madmarkarnel/lora-transmission/pcb board/atsamdg21/atsamdg21_v1.20.brd

## EAGLE design pcb board/atsamdg21/atsamdg21_v1.20.brd (2020-06-10)

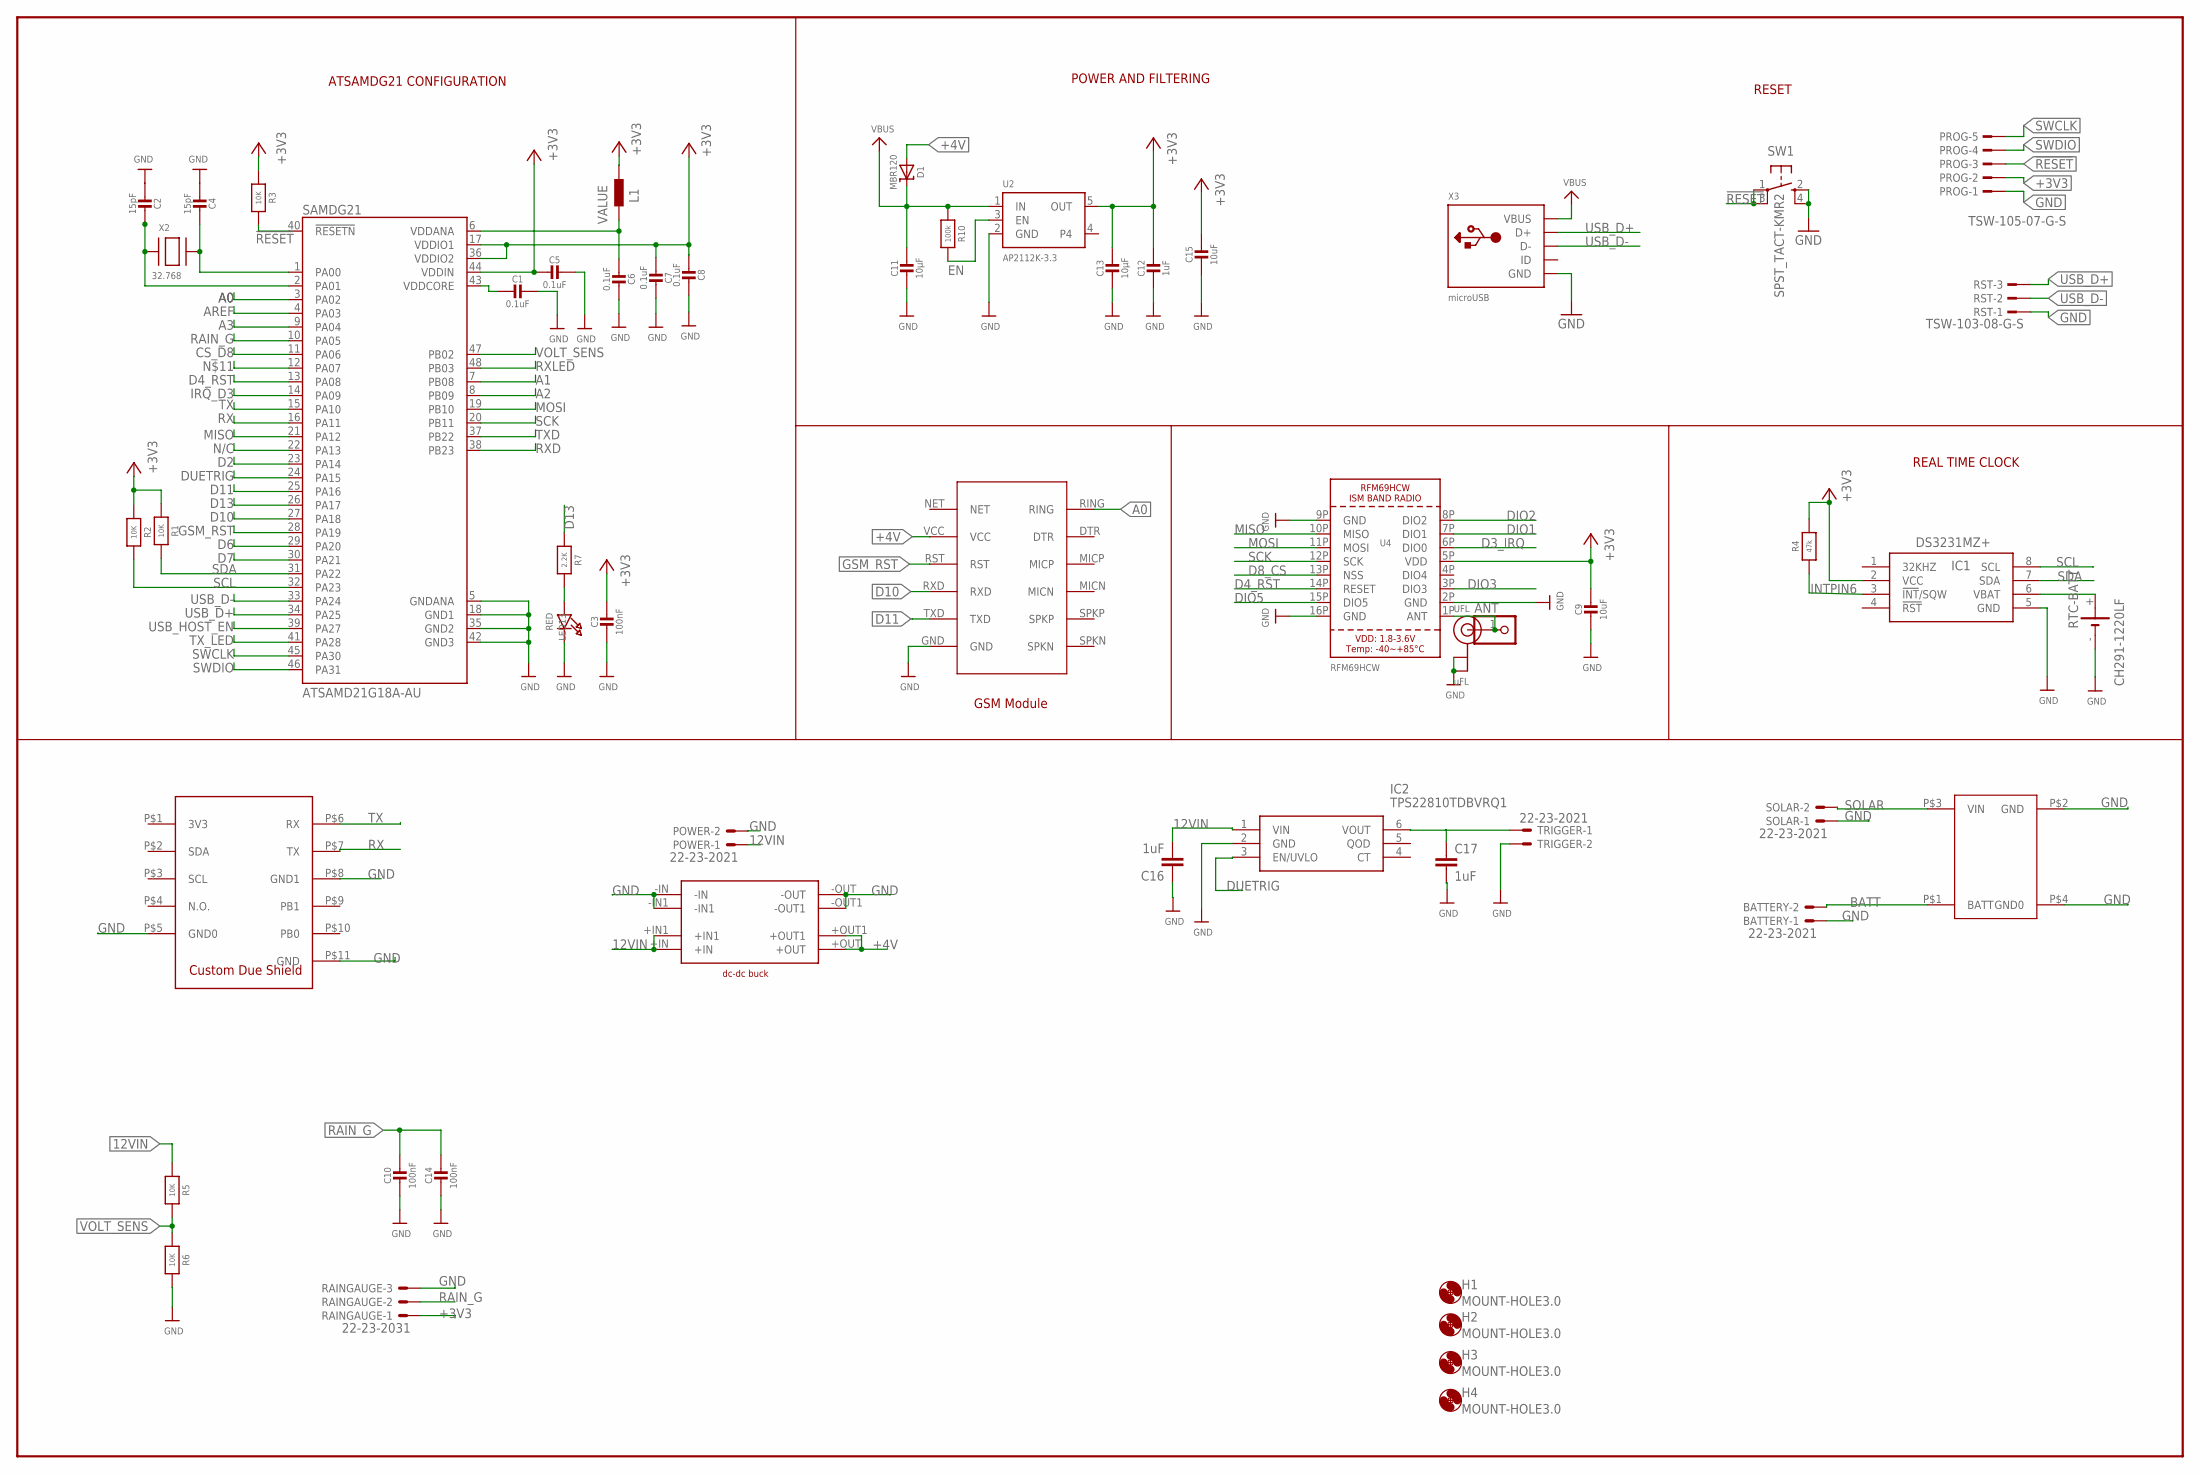
[picture p1: schematic atsamdg21_v1.20.sch]

Parts:
ANT: HEADER-1X1ROUND; 1X01_ROUND
BATTERY: 22-23-2021
C1, C5, C6, C7, C8: 0.1uF; 0603-NO
C2, C4: 15pF; 0603-NO
C3, C10, C14: 100nF; 0603-NO
C9, C15: 10uF; 0805-NO
C11, C13: 10µF; 0805-NO
C12: 1uF; 0603-NO
C16, C17: 1uF; C0603
D1: MBR120; SOD-123
H1, H2, H3, H4: MOUNT-HOLE3.0; 3,0
IC1: DS3231MZ+; SOIC127P600X175-8N
IC2: TPS22810TDBVRQ1; SOT95P280X145-6N
L1: BLM15HB121SN1; 0402
LED13: RED; CHIPLED_0805_NOOUTLINE
POWER: 22-23-2021
PROG: TSW-105-07-G-S; TSW-105-XX-G-S
R1, R2, R3, R5, R6: 10K; 0603-NO
R4: 47k; 0603-NO
R7: 2.2K; 0603-NO
R10: 100k; 0603-NO
RAINGAUGE: 22-23-2031
RST: TSW-103-08-G-S; TSW-103-XX-G-S
RTC-BATT: CH291-1220LF
SAMDG21: ATSAMD21G18A-AU; QFP50P900X900X120-48N
SOLAR: 22-23-2021
SW1: SPST_TACT-KMR2; KMR2
TRIGGER: 22-23-2021
U2: AP2112K-3.3; SOT23-5
U4: RFM69HCW; RFMHCW_SMT
U$7: SIM800L_MODULE; SIM800L
U$19: DC-DC_BUCK_MAD; DC-DC_BUCK
U$20: DUE_PADSDUE_GSM; DUESHIELD_BIG
U$36: LI-ION-CHARGER; LI-ION
UFL: uFL; U.FL
X2: 32.768; XTAL3215
X3: microUSB; 4UCONN_20329_V2

Connections:
12VIN: C16.2, IC2.1 (VIN), POWER.1, R5.1, U$19.+IN, U$19.+IN1
!RESET: PROG.3, R3.2, SAMDG21.40 (!RESETN), SW1.1, SW1.3 (P1)
+3V3: C3.1, C5.2, C7.2, C8.2, C9.1, C12.1, C13.1, C15.1, IC1.2 (VCC), L1.1, PROG.2, R1.1, R2.1, R3.1, R4.2, RAINGAUGE.1, SAMDG21.17 (VDDIO1), SAMDG21.36 (VDDIO2), SAMDG21.44 (VDDIN), U2.5 (OUT), U4.5P (VDD)
+4V: D1.A, U$7.VCC, U$19.+OUT, U$19.+OUT1
A0: SAMDG21.3 (PA02), U$7.RING
A1: SAMDG21.7 (PB08)
A2: SAMDG21.8 (PB09)
A3: SAMDG21.9 (PA04)
ANT: ANT.1, U4.1P (ANT), UFL.3 (SIGNAL)
AREF: SAMDG21.4 (PA03)
BATT: BATTERY.2, U$36.P$1 (BATT)
CS_D8: SAMDG21.11 (PA06)
D2: SAMDG21.23 (PA14)
D3_IRQ: U4.6P (DIO0)
D4_RST: SAMDG21.13 (PA08), U4.14P (RESET)
D6: SAMDG21.29 (PA20)
D7: SAMDG21.30 (PA21)
D8_CS: U4.13P (NSS)
D10: SAMDG21.27 (PA18), U$7.RXD
D11: SAMDG21.25 (PA16), U$7.TXD
D13: R7.1, SAMDG21.26 (PA17)
DIO1: U4.7P (DIO1)
DIO2: U4.8P (DIO2)
DIO3: U4.3P (DIO3)
DIO5: U4.15P (DIO5)
DUETRIG: IC2.3 (EN/UVLO), SAMDG21.24 (PA15)
EN: R10.2, U2.3 (EN)
GND: BATTERY.1, C1.1, C2.2, C3.2, C4.2, C5.1, C6.1, C7.1, C8.1, C9.2, C10.2, C11.2, C12.2, C13.2, C14.2, C15.2, C16.1, C17.2, IC1.5 (GND), IC2.2 (GND), LED13.C, POWER.2, PROG.1, R6.2, RAINGAUGE.3, RST.1, RTC-BATT.-, SAMDG21.5 (GNDANA), SAMDG21.18 (GND1), SAMDG21.35 (GND2), SAMDG21.42 (GND3), SOLAR.1, SW1.2 (S), SW1.4 (S1), TRIGGER.2, U2.2 (GND), U4.2P (GND), U4.9P (GND), U4.16P (GND), U$7.GND, U$19.-IN, U$19.-IN1, U$19.-OUT, U$19.-OUT1, U$20.P$5 (GND0), U$20.P$8 (GND1), U$20.P$11 (GND), U$36.P$2 (GND), U$36.P$4 (GND0), UFL.1 (GND), UFL.2 (GND), X3.BASE@1 (GND), X3.BASE@2 (GND), X3.GND, X3.SPRT@1 (GND), X3.SPRT@2 (GND), X3.SPRT@3 (GND), X3.SPRT@4 (GND)
GSM_RST: SAMDG21.28 (PA19), U$7.RST
INTPIN6: IC1.3 (!INT!/SQW), R4.1
IRQ_D3: SAMDG21.14 (PA09)
MISO: SAMDG21.21 (PA12), U4.10P (MISO)
MOSI: SAMDG21.19 (PB10), U4.11P (MOSI)
unnamed: C1.2, SAMDG21.43 (VDDCORE)
unnamed: IC1.6 (VBAT), RTC-BATT.+
unnamed: C6.2, L1.2, SAMDG21.6 (VDDANA)
unnamed: C2.1, SAMDG21.2 (PA01), X2.P$1
unnamed: C17.1, IC2.6 (VOUT), TRIGGER.1
unnamed: C4.1, SAMDG21.1 (PA00), X2.P$2
unnamed: LED13.A, R7.2
N/C: SAMDG21.22 (PA13)
RAIN_G: C10.1, C14.1, RAINGAUGE.2, SAMDG21.10 (PA05)
RX: SAMDG21.16 (PA11), U$20.P$7 (TX)
RXD: SAMDG21.38 (PB23)
RXLED: SAMDG21.48 (PB03)
SCK: SAMDG21.20 (PB11), U4.12P (SCK)
SCL: IC1.8 (SCL), R2.2, SAMDG21.32 (PA23)
SDA: IC1.7 (SDA), R1.2, SAMDG21.31 (PA22)
SOLAR: SOLAR.2, U$36.P$3 (VIN)
SWCLK: PROG.5, SAMDG21.45 (PA30)
SWDIO: PROG.4, SAMDG21.46 (PA31)
TX: SAMDG21.15 (PA10), U$20.P$6 (RX)
TXD: SAMDG21.37 (PB22)
TX_LED: SAMDG21.41 (PA28)
USB_D+: RST.3, SAMDG21.34 (PA25), X3.D+
USB_D-: RST.2, SAMDG21.33 (PA24), X3.D-
USB_HOST_EN: SAMDG21.39 (PA27)
VBUS: C11.1, D1.C, R10.1, U2.1 (IN), X3.VBUS
VOLT_SENS: R5.2, R6.1, SAMDG21.47 (PB02)

Notes on the sheet:
GSM Module
POWER AND FILTERING
RESET
ATSAMDG21 CONFIGURATION
REAL TIME CLOCK

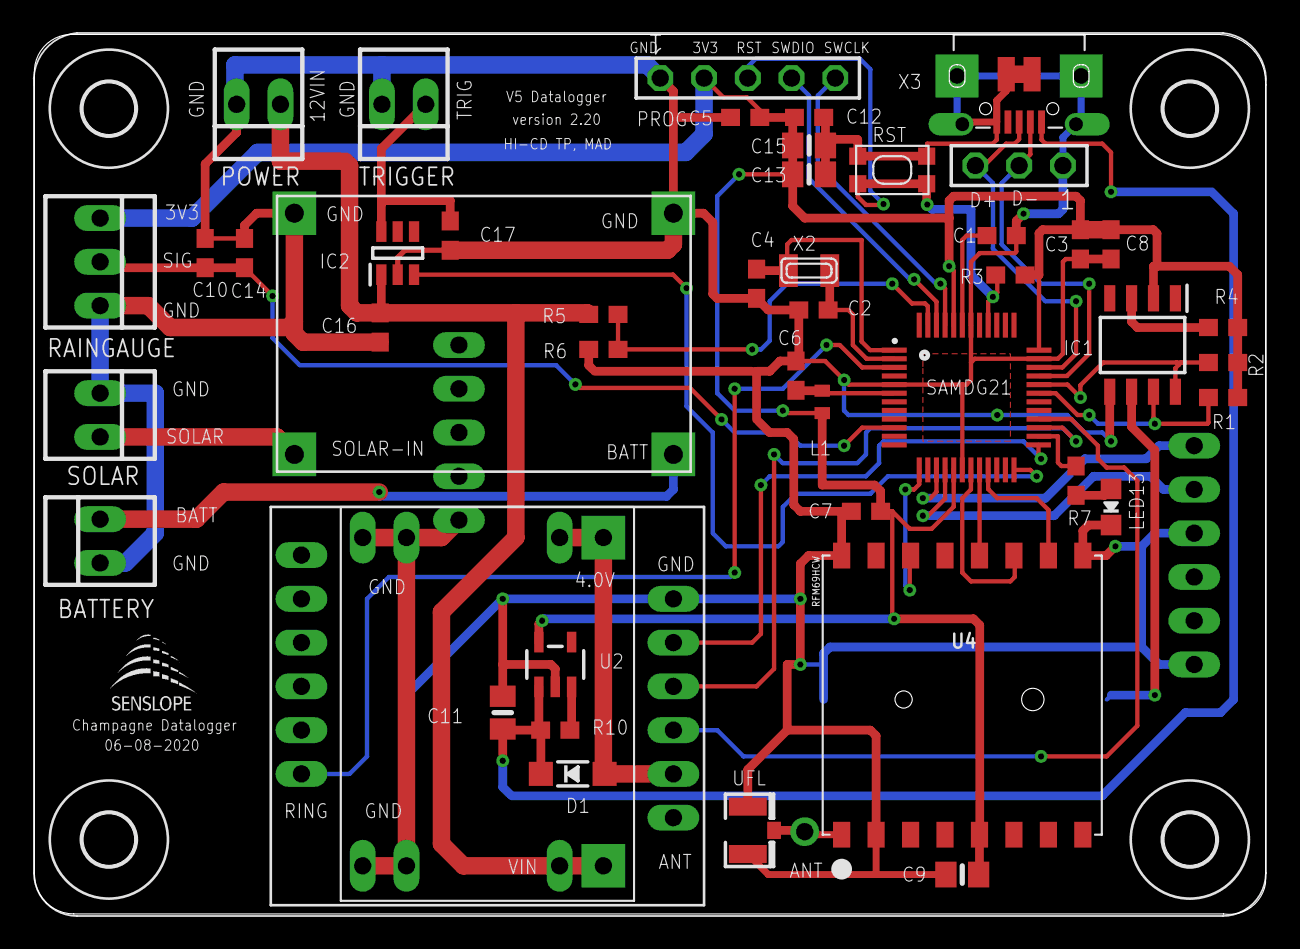
[picture p2: board atsamdg21_v1.20.brd from above]

Board: 2 copper layers, 71.5 x 51.1 mm, 55 parts (1 on the bottom side), 38 nets.

Other parts of the board:
U$24: LOGO_SML_TNAME
