madmarkarnel/lora-transmission/pcb board/gsm_LoRa/gsm_LoRa_due.brd

## EAGLE design pcb board/gsm_LoRa/gsm_LoRa_due.brd (2020-06-09)

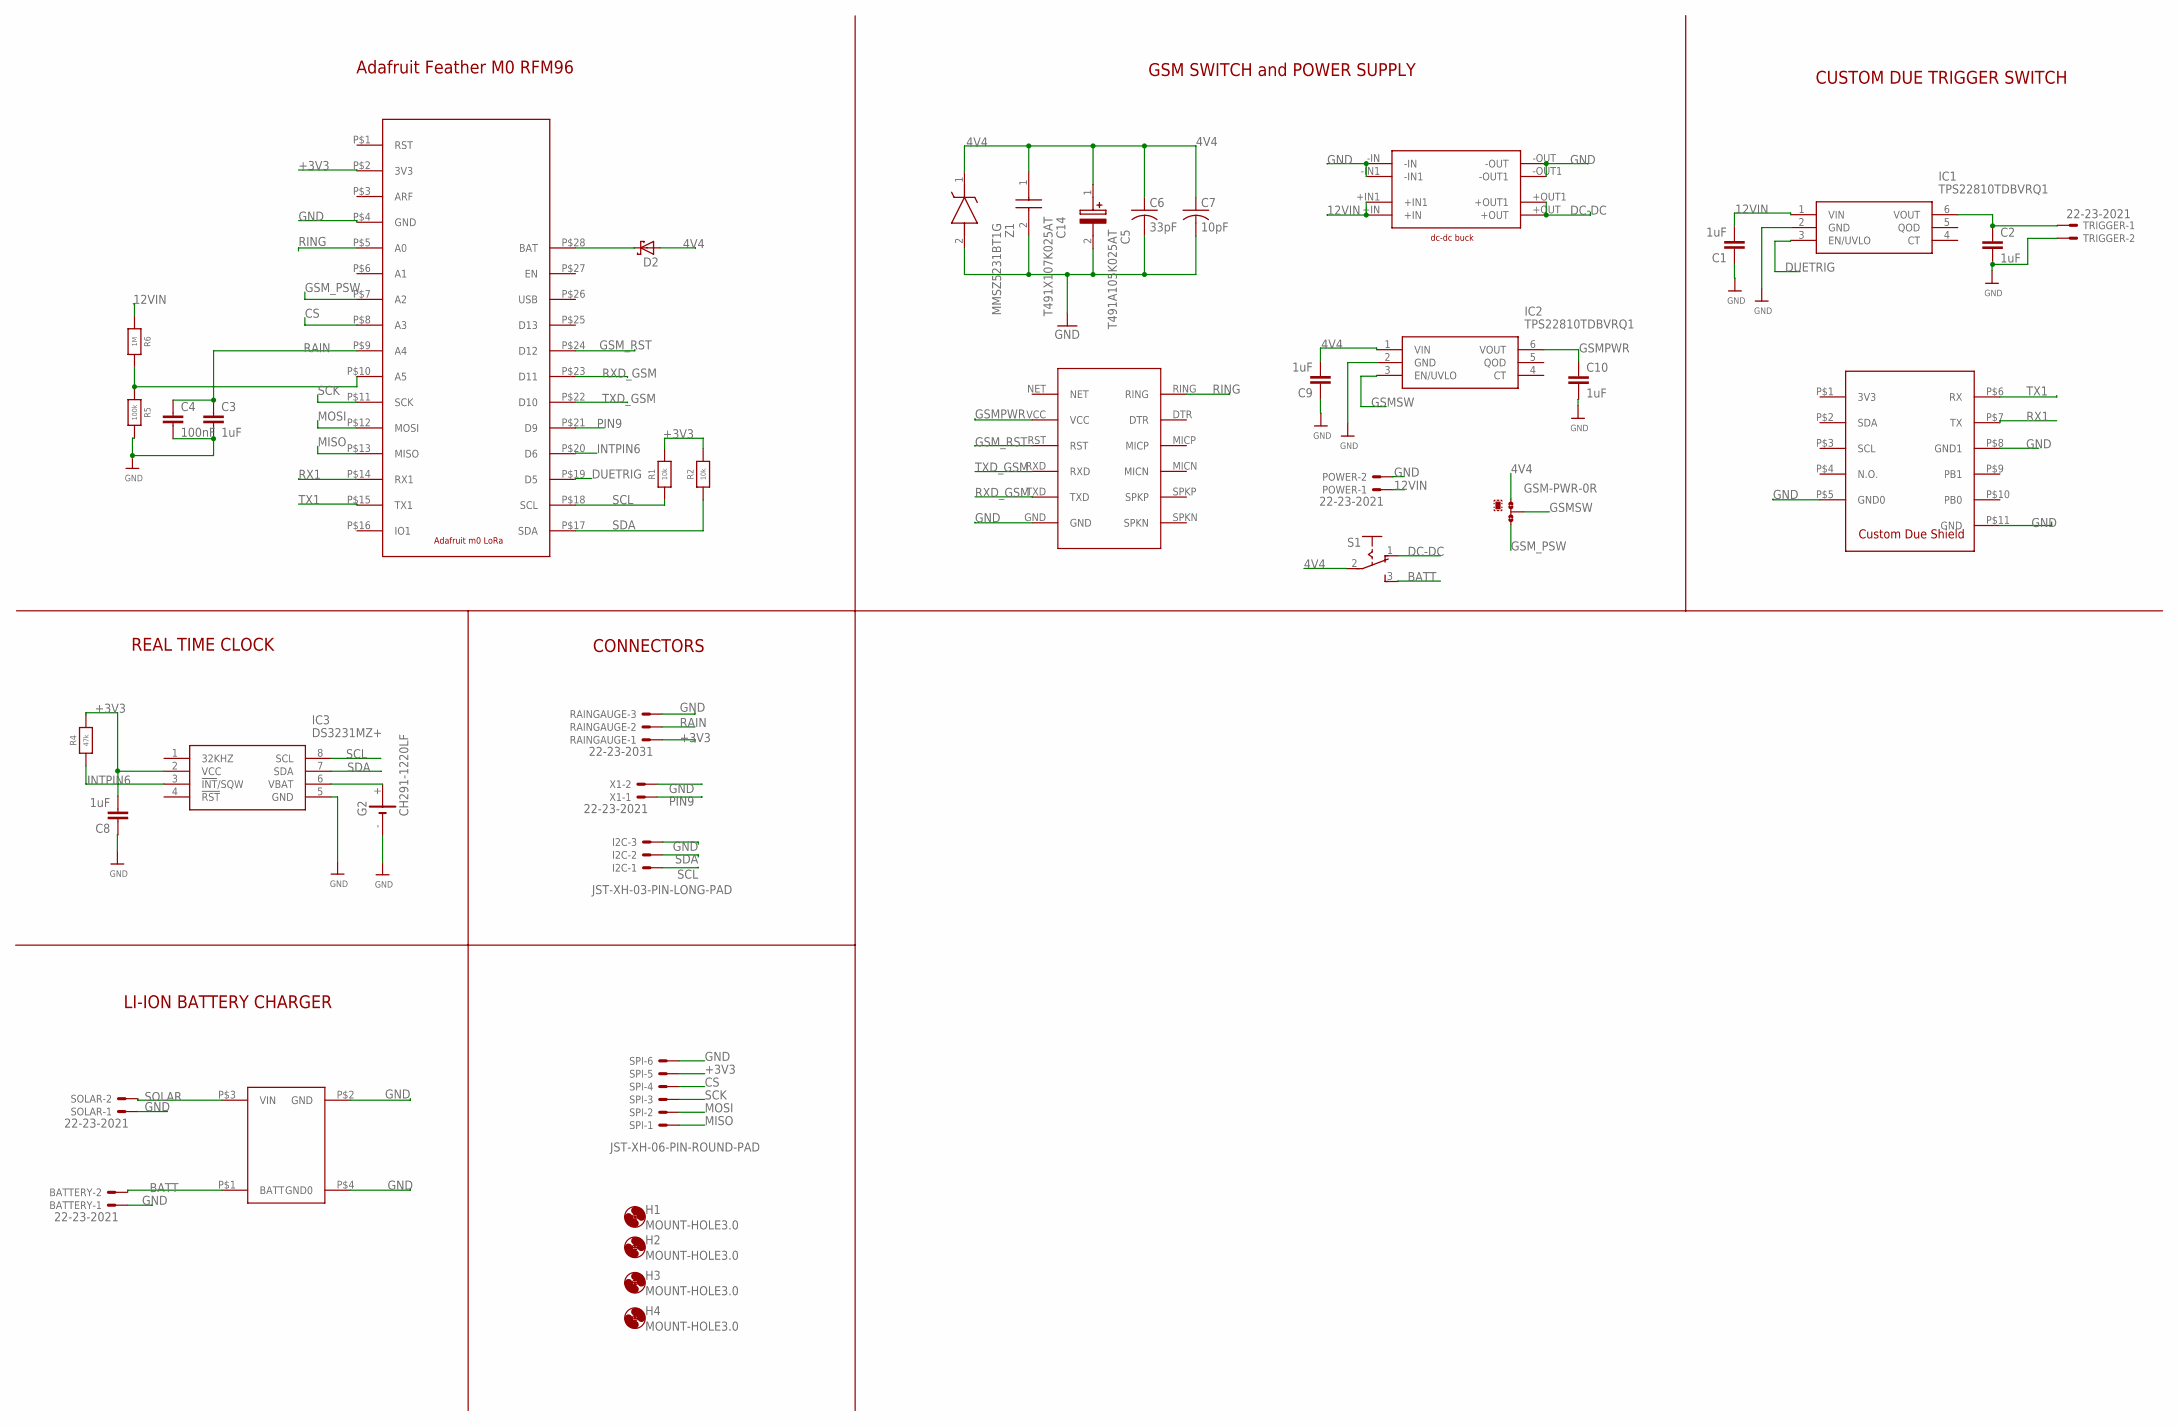
[picture p3: schematic gsm_LoRa_due.sch]

Parts:
BATTERY: 22-23-2021
C1, C2, C3, C8, C9, C10: 1uF; C0603
C4: 100nF; C0603
C5: T491A105K025AT; CAPPM3216X180N
C6: 33pF; C0603
C7: 10pF; C0603
C14: T491X107K025AT; CAPPM7343X430N
D2: SCHOTTKY-DIODE; DIODE_SMB
G2: CH291-1220LF
GSM-PWR: 0R-JUMPB; B0R-JMP
H1, H2, H3, H4: MOUNT-HOLE3.0; 3,0
I2C: JST-XH-03-PIN-LONG-PAD; JST-XH-03-PACKAGE-LONG-PAD
IC1, IC2: TPS22810TDBVRQ1; SOT95P280X145-6N
IC3: DS3231MZ+; SOIC127P600X175-8N
POWER: 22-23-2021
R1, R2: 10k; 0603-NO
R4: 47k; 0603-NO
R5: 100k; 0603-NO
R6: 1M; 0603-NO
RAINGAUGE: 22-23-2031
S1: 255SB
SOLAR: 22-23-2021
SPI: JST-XH-06-PIN-ROUND-PAD; JST-XH-06-PACKAGE-ROUND-PAD
TRIGGER: 22-23-2021
U$1: M0_LORA; RFM69
U$8: DUE_PADSDUE_GSM; DUESHIELD_BIG
U$9: SIM800L_MODULE; SIM800L
U$10: DC-DC_BUCK_MAD; DC-DC_BUCK
U$11: LI-ION-CHARGER; LI-ION
X1: 22-23-2021
Z1: MMSZ5231BT1G; SOD3716X135N

Connections:
4V4: C5.1 (+), C6.1, C7.1, C9.2, C14.1, D2.A (C), GSM-PWR.1, IC2.1 (VIN), S1.2, Z1.1 (K)
12VIN: C1.2, IC1.1 (VIN), POWER.1, R6.1, U$10.+IN, U$10.+IN1
+3V3: C8.2, IC3.2 (VCC), R1.2, R2.2, R4.2, RAINGAUGE.1, SPI.5, U$1.P$2 (3V3)
BATT: BATTERY.2, S1.3 (S), U$11.P$1 (BATT)
CS: SPI.4, U$1.P$8 (A3)
DC-DC: S1.1 (O), U$10.+OUT, U$10.+OUT1
DUETRIG: IC1.3 (EN/UVLO), U$1.P$19 (D5)
GND: BATTERY.1, C1.1, C2.2, C3.2, C4.2, C5.2 (-), C6.2, C7.2, C8.1, C9.1, C10.2, C14.2, G2.-, I2C.3, IC1.2 (GND), IC2.2 (GND), IC3.5 (GND), POWER.2, R5.2, RAINGAUGE.3, SOLAR.1, SPI.6, TRIGGER.2, U$1.P$4 (GND), U$8.P$5 (GND0), U$8.P$8 (GND1), U$8.P$11 (GND), U$9.GND, U$10.-IN, U$10.-IN1, U$10.-OUT, U$10.-OUT1, U$11.P$2 (GND), U$11.P$4 (GND0), X1.2, Z1.2 (A)
GSMPWR: C10.1, IC2.6 (VOUT), U$9.VCC
GSMSW: GSM-PWR.2, IC2.3 (EN/UVLO)
GSM_PSW: GSM-PWR.3, U$1.P$7 (A2)
GSM_RST: U$1.P$24 (D12), U$9.RST
INTPIN6: IC3.3 (!INT!/SQW), R4.1, U$1.P$20 (D6)
MISO: SPI.1, U$1.P$13 (MISO)
MOSI: SPI.2, U$1.P$12 (MOSI)
unnamed: D2.C (A), U$1.P$28 (BAT)
unnamed: G2.+, IC3.6 (VBAT)
unnamed: R5.1, R6.2, U$1.P$10 (A5)
unnamed: C2.1, IC1.6 (VOUT), TRIGGER.1
PIN9: U$1.P$21 (D9), X1.1
RAIN: C3.1, C4.1, RAINGAUGE.2, U$1.P$9 (A4)
RING: U$1.P$5 (A0), U$9.RING
RX1: U$1.P$14 (RX1), U$8.P$7 (TX)
RXD_GSM: U$1.P$23 (D11), U$9.TXD
SCK: SPI.3, U$1.P$11 (SCK)
SCL: I2C.1, IC3.8 (SCL), R1.1, U$1.P$18 (SCL)
SDA: I2C.2, IC3.7 (SDA), R2.1, U$1.P$17 (SDA)
SOLAR: SOLAR.2, U$11.P$3 (VIN)
TX1: U$1.P$15 (TX1), U$8.P$6 (RX)
TXD_GSM: U$1.P$22 (D10), U$9.RXD

Notes on the sheet:
Adafruit Feather M0 RFM96
GSM SWITCH and POWER SUPPLY
CUSTOM DUE TRIGGER SWITCH
REAL TIME CLOCK
CONNECTORS
LI-ION BATTERY CHARGER

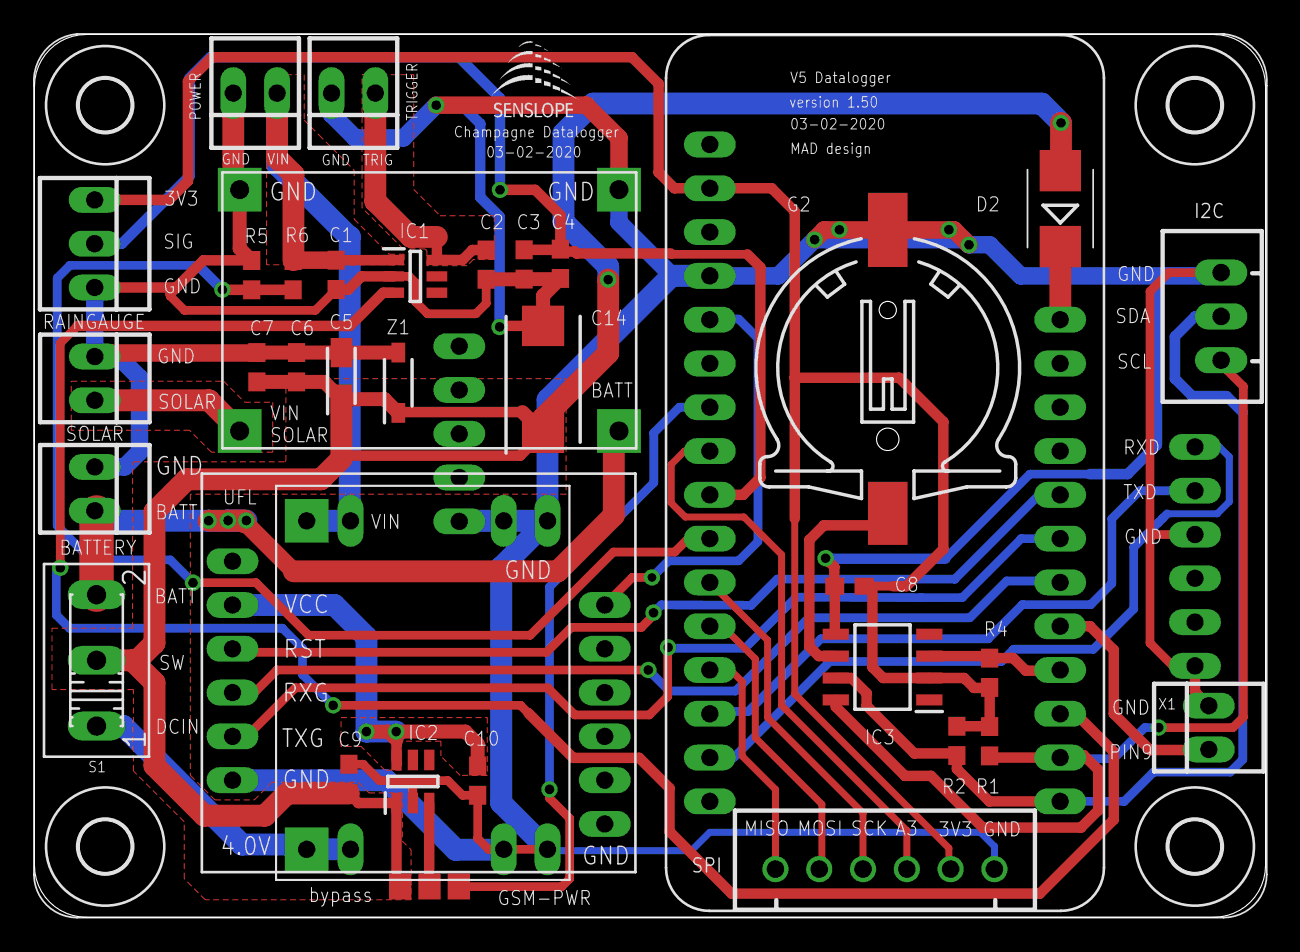
[picture p4: board gsm_LoRa_due.brd from above]

Board: 2 copper layers, 71.4 x 51.2 mm, 42 parts (0 on the bottom side), 30 nets.

Other parts of the board:
U$13: LOGO_SML_TNAME
