madmarkarnel/lora-transmission/pcb board/m0_BareBones/atsamdg21_rtc.brd

## EAGLE design pcb board/m0_BareBones/atsamdg21_rtc.brd (2020-02-28)

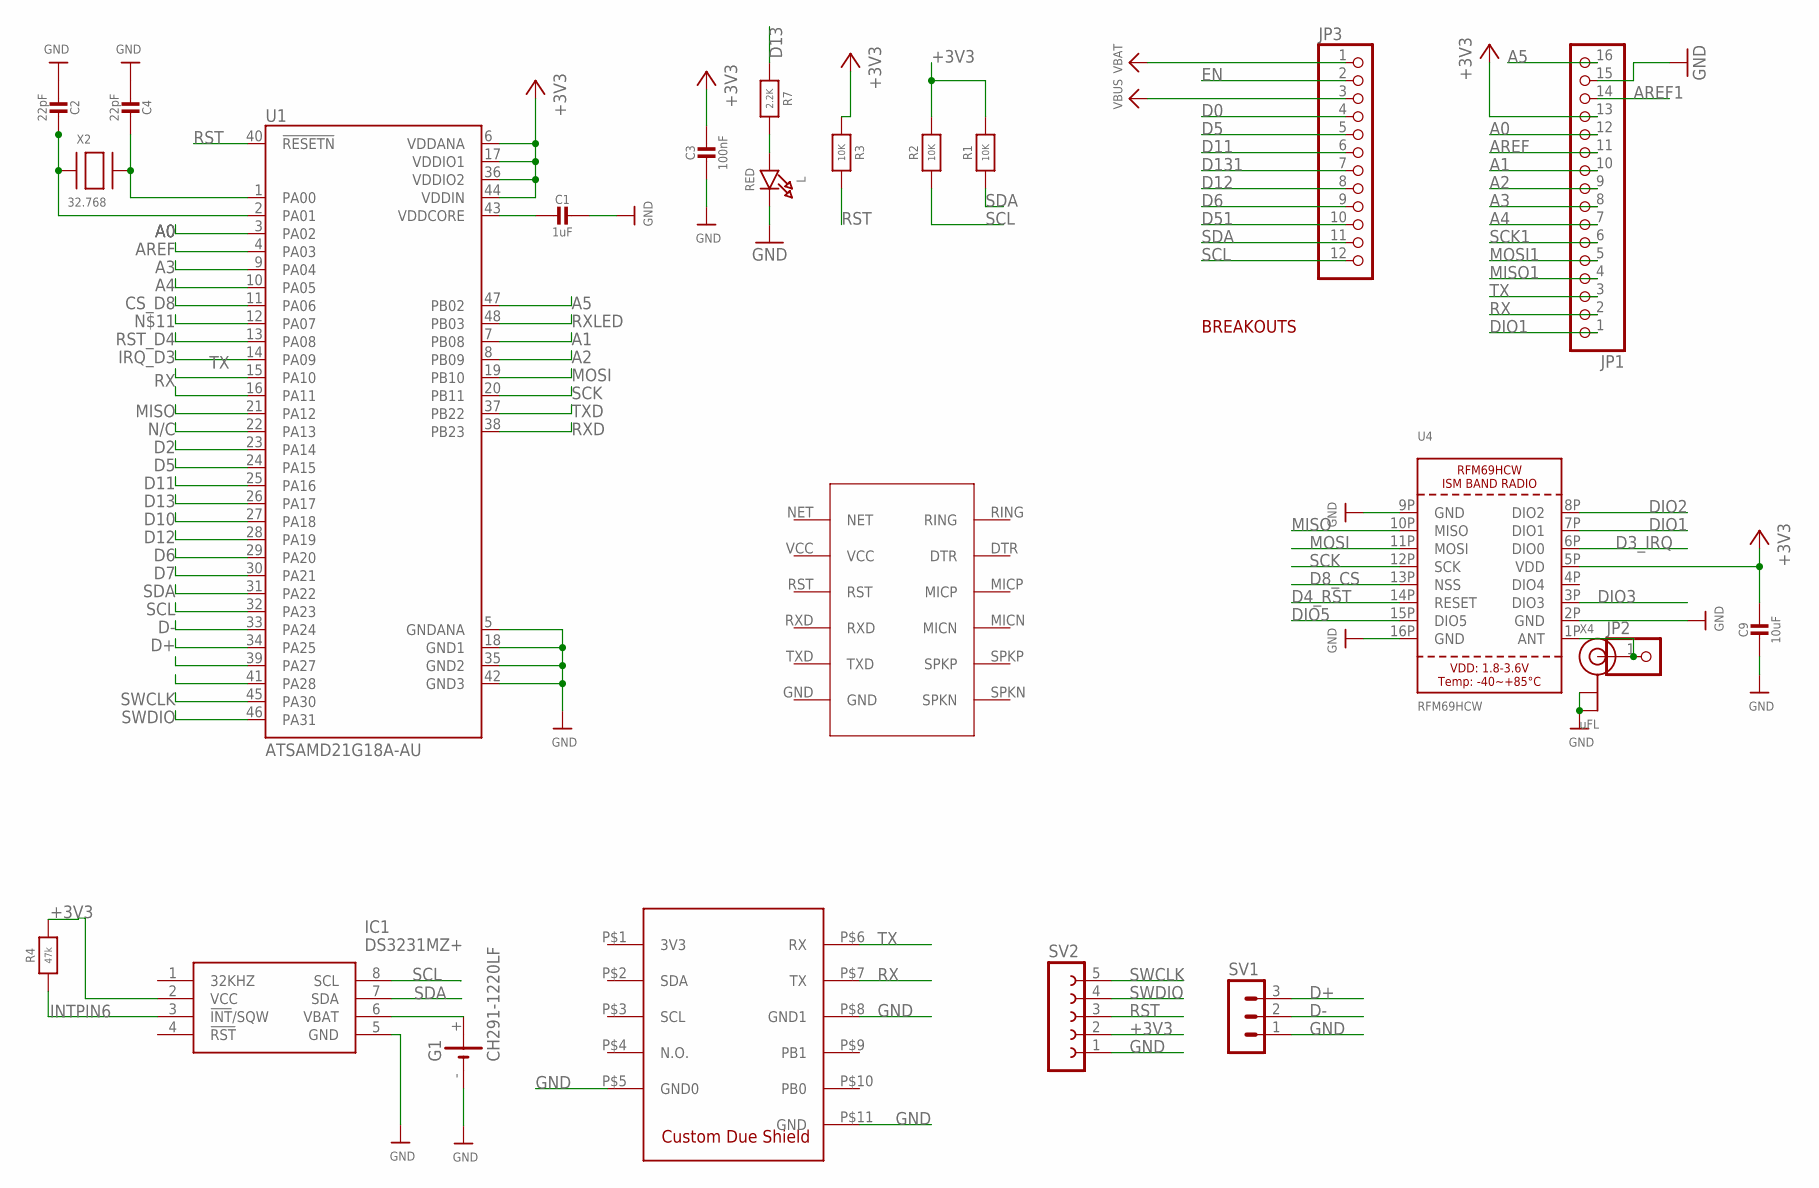
[picture p5: schematic atsamdg21_rtc.sch]

Parts:
C1: 1uF; 0603-NO
C2, C4: 22pF; 0603-NO
C3: 100nF; 0603-NO
C9: 10uF; 0805-NO
G1: CH291-1220LF
IC1: DS3231MZ+; SOIC127P600X175-8N
JP1: HEADER-1X16ROUND; 1X16_ROUND
JP2: HEADER-1X1ROUND; 1X01_ROUND
JP3: HEADER-1X12; 1X12_ROUND
L: RED; CHIPLED_0805_NOOUTLINE
R1, R2, R3: 10K; 0603-NO
R4: 47k; 0603-NO
R7: 2.2K; 0603-NO
SV1: MA03-1
SV2: FE05-1
U1: ATSAMD21G18A-AU; QFP50P900X900X120-48N
U4: RFM69HCW; RFMHCW_SMT
U$7: SIM800L_MODULE; SIM800L
U$9: DUE_PADS; DUESHIELD
X2: 32.768; XTAL3215
X4: uFL; U.FL

Connections:
+3V3: C3.1, C9.1, IC1.2 (VCC), JP1.13, R1.2, R2.2, R3.1, R4.2, SV2.2, U1.6 (VDDANA), U1.17 (VDDIO1), U1.36 (VDDIO2), U1.44 (VDDIN), U4.5P (VDD)
A0: JP1.12, U1.3 (PA02)
A1: JP1.10, U1.7 (PB08)
A2: JP1.9, U1.8 (PB09)
A3: JP1.8, U1.9 (PA04)
A4: JP1.7, U1.10 (PA05)
A5: JP1.16, U1.47 (PB02)
ANT: JP2.1, U4.1P (ANT), X4.3 (SIGNAL)
AREF: JP1.11, U1.4 (PA03)
AREF1: JP1.14
CS_D8: U1.11 (PA06)
D0: JP3.4
D2: U1.23 (PA14)
D3_IRQ: U4.6P (DIO0)
D4_RST: U4.14P (RESET)
D5: JP3.5, U1.24 (PA15)
D6: JP3.9, U1.29 (PA20)
D7: U1.30 (PA21)
D8_CS: U4.13P (NSS)
D10: U1.27 (PA18)
D11: JP3.6, U1.25 (PA16)
D12: JP3.8, U1.28 (PA19)
D13: R7.1, U1.26 (PA17)
D51: JP3.10
D131: JP3.7
D+: SV1.3, U1.34 (PA25)
D-: SV1.2, U1.33 (PA24)
DIO1: JP1.1, U4.7P (DIO1)
DIO2: U4.8P (DIO2)
DIO3: U4.3P (DIO3)
DIO5: U4.15P (DIO5)
EN: JP3.2
GND: C1.1, C2.2, C3.2, C4.2, C9.2, G1.-, IC1.5 (GND), JP1.15, L.C, SV1.1, SV2.1, U1.5 (GNDANA), U1.18 (GND1), U1.35 (GND2), U1.42 (GND3), U4.2P (GND), U4.9P (GND), U4.16P (GND), U$9.P$5 (GND0), U$9.P$8 (GND1), U$9.P$11 (GND), X4.1 (GND), X4.2 (GND)
INTPIN6: IC1.3 (!INT!/SQW), R4.1
IRQ_D3: U1.14 (PA09)
MISO: U1.21 (PA12), U4.10P (MISO)
MISO1: JP1.4
MOSI: U1.19 (PB10), U4.11P (MOSI)
MOSI1: JP1.5
unnamed: C1.2, U1.43 (VDDCORE)
unnamed: G1.+, IC1.6 (VBAT)
unnamed: C2.1, U1.2 (PA01), X2.P$1
unnamed: C4.1, U1.1 (PA00), X2.P$2
unnamed: L.A, R7.2
N/C: U1.22 (PA13)
RST: R3.2, SV2.3, U1.40 (!RESETN)
RST_D4: U1.13 (PA08)
RX: JP1.2, U1.16 (PA11), U$9.P$7 (TX)
RXD: U1.38 (PB23)
RXLED: U1.48 (PB03)
SCK: U1.20 (PB11), U4.12P (SCK)
SCK1: JP1.6
SCL: IC1.8 (SCL), JP3.12, R2.1, U1.32 (PA23)
SDA: IC1.7 (SDA), JP3.11, R1.1, U1.31 (PA22)
SWCLK: SV2.5, U1.45 (PA30)
SWDIO: SV2.4, U1.46 (PA31)
TX: JP1.3, U1.15 (PA10), U$9.P$6 (RX)
TXD: U1.37 (PB22)
VBAT: JP3.1
VBUS: JP3.3

Notes on the sheet:
BREAKOUTS

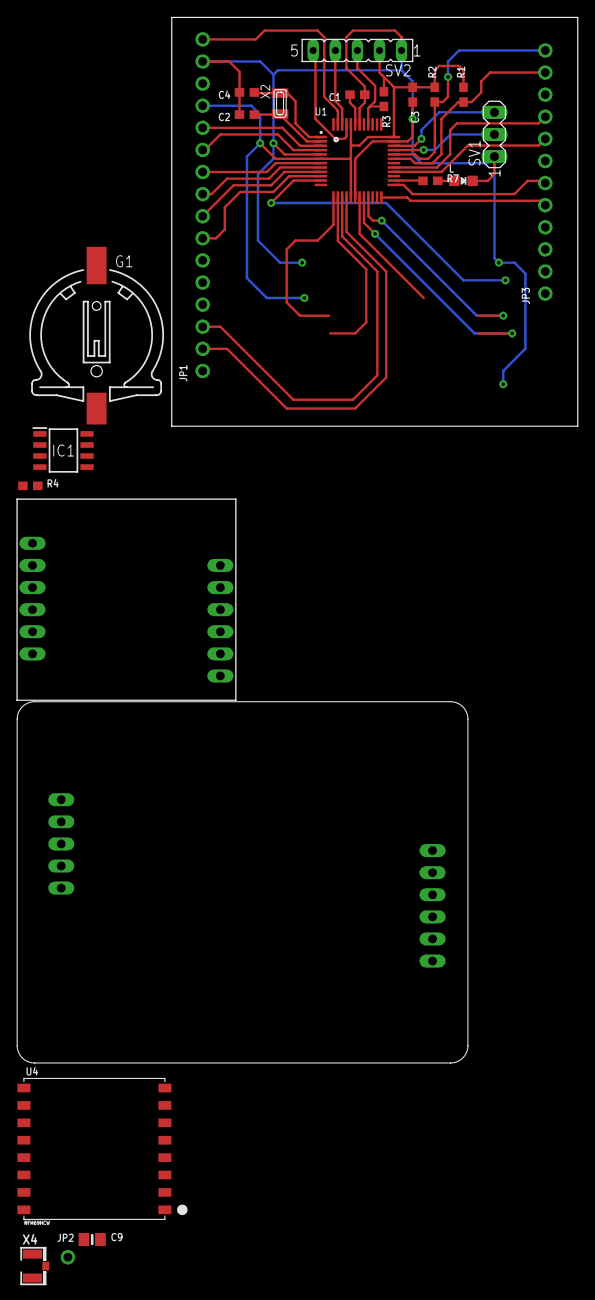
[picture p6: board atsamdg21_rtc.brd from above]

Board: 2 copper layers, 46.7 x 47.0 mm, 24 parts (0 on the bottom side), 34 nets.
