madmarkarnel/lora-transmission/m0_sleep/m0_sleep.ino

/**
 * Arabica datalogger

Features:
* Sends sensor data via LoRa for version 4 datalogger.
* Built-in rtc with configurable wake interrupt.
* Low power mode ~1mA

The circuit:
* Adafruit Feather M0 with RFM95 433MHz
* Arabica Board with rtc

Created: 12 October 2019
By : MAD, TEP
Modified: 29 May 2020
*/

#include <Wire.h>
#include <LowPower.h>
#include "Sodaq_DS3231.h"
#include <SPI.h>
#include <RH_RF95.h>
#include <avr/dtostrf.h> // dtostrf missing in Arduino Zero/Due
#include <EnableInterrupt.h>
#include <FlashStorage.h>
#include <Arduino.h>        // required before wiring_private.h
#include "wiring_private.h" // pinPeripheral() function
#include <Regexp.h>
#include <string.h>

#define BAUDRATE 115200
#define DUEBAUD 9600
#define DUESerial Serial1
#define RTCINTPIN 6
#define DUETRIG 5
#define RSTMCU 9
#define DEBUG 1
#define VBATPIN A7
#define VBATEXT A5
#define GSMRST 12
#define GSMPWR A2
#define GSMDTR A1
#define GSMINT A0 //gsm ring interrupt

//gsm related
#define GSMBAUDRATE 9600
#define GSMSerial Serial2
#define MAXSMS 168

//for m0
#define RFM95_CS 8
#define RFM95_RST 4
#define RFM95_INT 3

#define RF95_FREQ 433.0         // Change to 434.0 or other frequency, must match RX's freq!
#define DATALEN 200             //max size of dummy length
#define LORATIMEOUT 500000      // 8.33 minutes delay
#define LORATIMEOUTMODE2 900000 // 15.0 mnutes
#define DUETIMEOUT 210000       // 3.50 minutes timeout
#define DUEDELAY 60000          // 1.0 minute delay
#define RAININT A4              //rainfall interrupt pin A4

// Singleton instance of the radio driver
RH_RF95 rf95(RFM95_CS, RFM95_INT);

//initialize LoRa global variables
char dataToSend[DATALEN]; //lora
uint8_t payload[RH_RF95_MAX_MESSAGE_LEN];
uint8_t len = sizeof(payload);

//LoRa received
uint8_t buf[RH_RF95_MAX_MESSAGE_LEN];
uint8_t len2 = sizeof(buf);
char received[250];

char streamBuffer[250]; //store message
char rssiString[250];
int customDueFlag = 0;  //for data gathering
int sendToLoRa = 0;
uint8_t tx_RSSI = 0;   //tx rssi of sensor A
uint8_t tx_RSSI_B = 0; //tx rssi of sensor B
uint8_t tx_RSSI_C = 0; //tx rssi of sensor C

//rain gauge
static unsigned long last_interrupt_time = 0;
const unsigned int DEBOUNCE_TIME = 40; //40
volatile float rainTips = 0.00;
char sendRainTip[7] = "0.00";

volatile bool gsmRingFlag = false;  //gsm interrupt
volatile bool rainFallFlag = false; //rain tips
volatile bool OperationFlag = false;
bool getSensorDataFlag = false;

char station_name[6] = "MADTA";
char Ctimestamp[13] = "";
char command[30];
char txVoltage[100] = "0";
char txVoltageB[100] = "0";
char txVoltageC[100] = "0";

unsigned long timestart = 0;
uint8_t serial_flag = 0;
uint8_t debug_flag = 0;
uint8_t rcv_LoRa_flag = 0;
uint16_t store_rtc = 00; //store rtc alarm

String serverNumber = ("639175972526");

/* Pin 11-Rx ; 10-Tx (GSM comms) */
Uart Serial2(&sercom1, 11, 10, SERCOM_RX_PAD_0, UART_TX_PAD_2);
void SERCOM1_Handler()
{
  Serial2.IrqHandler();
}

typedef struct
{
  boolean valid;
  char senslopeCommand[50];
  char stationName[10];
} Senslope;
Senslope sensCommand; 

typedef struct
{
  boolean valid;
  char sensorA[20];
  char sensorB[20];
  char sensorC[20];
  char sensorD[20];
} SensorName;
SensorName loggerName;

typedef struct
{
  boolean valid;
  char inputNumber[50];
} serNumber;
serNumber flashServerNumber;

typedef struct
{
  boolean valid;
  char keyword[50];
} smsPassword;
smsPassword flashPassword;

/**
 * Reserve a portion of flash memory to store an "int" variable
 * and call it "alarmStorage".
*/
FlashStorage(alarmStorage, int);
FlashStorage(loggerVersion, int);
FlashStorage(passCommand, Senslope);
FlashStorage(newServerNum, serNumber);
FlashStorage(flashLoggerName, SensorName);
FlashStorage(flashPasswordIn, smsPassword);

void (*resetFunc)(void) = 0;

void setup()
{
  digitalWrite(RSTMCU, HIGH); //MCU hard reset pin
  Serial.begin(BAUDRATE);
  DUESerial.begin(DUEBAUD);
  GSMSerial.begin(9600);

  /* Assign pins 10 & 11 UART SERCOM functionality */
  pinPeripheral(10, PIO_SERCOM);
  pinPeripheral(11, PIO_SERCOM);

  Wire.begin();
  rtc.begin();
  init_lora();

  pinMode(LED_BUILTIN, OUTPUT);
  pinMode(DUETRIG, OUTPUT);
  pinMode(GSMPWR, OUTPUT);
  pinMode(GSMRST, OUTPUT);
  pinMode(RSTMCU, OUTPUT); //MCU hard reset pin

  digitalWrite(LED_BUILTIN, LOW);
  digitalWrite(DUETRIG, LOW);
  digitalWrite(GSMPWR, LOW);
  digitalWrite(GSMRST, HIGH);

  /* rain gauge interrupt */
  attachInterrupt(RAININT, rainISR, FALLING);
  /* rtc interrupt */
  attachInterrupt(RTCINTPIN, wake, FALLING);
  /* ring interrupt */
  attachInterrupt(GSMINT, ringISR, FALLING);

  init_Sleep(); //initialize MCU sleep state

  setAlarmEvery30(alarmFromFlashMem()); //rtc alarm settings
  rf95.sleep();

  /*Enter DEBUG mode within 10 seconds*/
  Serial.println("Press 'C' to go DEBUG mode!");
  unsigned long serStart = millis();
  while (serial_flag == 0)
  {
    if (Serial.available())
    {
      debug_flag = 1;
      Serial.println("Debug Mode!");
      serial_flag = 1;
    }
    // timeOut in case walang serial na makuha in ~10 seconds
    if ((millis() - serStart) > 10000)
    {
      serStart = millis();
      serial_flag = 1;
    }
  }
/*
  if (get_logger_version() == 2 || get_logger_version() == 6 || get_logger_version() == 7)
  {
    //
  }
  else
  {
    turn_ON_GSM();
  }
  */
  flashLed(LED_BUILTIN, 5, 100);
}

void loop()
{
  while (debug_flag == 1)
  {
    getAtcommand();
  }

  if (OperationFlag)
  {
    flashLed(LED_BUILTIN, 2, 50);

    if (get_logger_version() == 1)
    {
      turn_ON_GSM();
      get_Due_Data(1, get_serverNum_from_flashMem());
      send_rain_data(0);
      if (getSensorDataFlag == true && OperationFlag == true)
      {
        receive_lora_data(1);
      }
      attachInterrupt(RTCINTPIN, wake, FALLING);
      turn_OFF_GSM();
    }
    else if (get_logger_version() == 2)
    {
      //LoRa transmitter of version 5 datalogger
      get_Due_Data(2, get_serverNum_from_flashMem());
      attachInterrupt(RTCINTPIN, wake, FALLING);
    }
    else if (get_logger_version() == 3)
    {
      //only one trasmitter
      turn_ON_GSM();
      send_rain_data(0);
      receive_lora_data(3);
      attachInterrupt(RTCINTPIN, wake, FALLING);
      turn_OFF_GSM();
    }
    else if (get_logger_version() == 4)
    {
      //Two transmitter
      turn_ON_GSM();
      send_rain_data(0);
      receive_lora_data(4);
      attachInterrupt(RTCINTPIN, wake, FALLING);
      turn_OFF_GSM();
    }
    else if (get_logger_version() == 5)
    {
      // Three transmitter
      turn_ON_GSM();
      send_rain_data(0);
      receive_lora_data(5);
      attachInterrupt(RTCINTPIN, wake, FALLING);
      turn_OFF_GSM();
    }
    else if (get_logger_version() == 6)
    {
      //default arabica LoRa transmitter
      get_Due_Data(0, get_serverNum_from_flashMem());
      attachInterrupt(RTCINTPIN, wake, FALLING);
    }
    else if (get_logger_version() == 7)
    {
      // Sends rain gauge data via LoRa
      get_Due_Data(0, get_serverNum_from_flashMem());
      delay(1000);
      send_rain_data(1);
      attachInterrupt(RTCINTPIN, wake, FALLING);
    }
    else if (get_logger_version() == 8)
    {
      // Sends rain gauge data via LoRa
      get_Due_Data(0, get_serverNum_from_flashMem());
      // delay(1000);
      // send_rain_data(1);
      // send_thru_lora(dataToSend);
      attachInterrupt(RTCINTPIN, wake, FALLING);
    }
    else
    {
      //default arQ like sending
      turn_ON_GSM();
      send_rain_data(0);
      get_Due_Data(1, get_serverNum_from_flashMem());
      attachInterrupt(RTCINTPIN, wake, FALLING);
      turn_OFF_GSM();
      sleepGSM();
    }

    rf95.sleep();
    getSensorDataFlag = false;
    OperationFlag = false;
  }

  if (rainFallFlag)
  {
    if (get_logger_version() == 2)
    {
      wakeGSM();
      flashLed(LED_BUILTIN, 2, 50);
      //LoRa transmitter of version 5 datalogger
      get_Due_Data(2, get_serverNum_from_flashMem());
      sleepGSM();
    }
    else
    {
      flashLed(LED_BUILTIN, 1, 50);
      attachInterrupt(RAININT, rainISR, FALLING);
      rainFallFlag = false;
    }
  }

  if (gsmRingFlag)
  {
    // wakeGSM();
    flashLed(LED_BUILTIN, 3, 50);

    GSMSerial.write("AT+CNMI=1,2,0,0,0\r");
    delay(300);
    while (GSMSerial.available() > 0)
    {
      processIncomingByte(GSMSerial.read());
    }

    attachInterrupt(GSMINT, ringISR, FALLING);
    // sleepGSM();
    gsmRingFlag = false;
  }

  setAlarmEvery30(alarmFromFlashMem());
  delay(75);
  rtc.clearINTStatus();

  attachInterrupt(GSMINT, ringISR, FALLING);
  attachInterrupt(RAININT, rainISR, FALLING);
  attachInterrupt(RTCINTPIN, wake, FALLING);
  sleepNow();
}

void wakeAndSleep(uint8_t verSion)
{
  if (OperationFlag)
  {
    flashLed(LED_BUILTIN, 5, 100);

    if (verSion == 1)
    {
      get_Due_Data(2, get_serverNum_from_flashMem()); //tx of v5 logger
    }
    else
    {
      get_Due_Data(0, get_serverNum_from_flashMem()); //default arabica
    }

    setAlarmEvery30(alarmFromFlashMem());
    rtc.clearINTStatus(); // needed to re-trigger rtc
    rf95.sleep();
    OperationFlag = false;
  }
  // working as of May 28, 2019
  sleepNow();
  /*
  attachInterrupt(digitalPinToInterrupt(RTCINTPIN), wake, FALLING);
  SysTick->CTRL &= ~SysTick_CTRL_TICKINT_Msk; //disable systick interrupt
  LowPower.standby();                         //enters sleep mode
  SysTick->CTRL |= SysTick_CTRL_TICKINT_Msk;  //Enabale systick interrupt
  */
}

/*Enable sleep-standby*/
void sleepNow()
{
  SysTick->CTRL &= ~SysTick_CTRL_TICKINT_Msk; //disable systick interrupt
  LowPower.standby();                         //enters sleep mode
  SysTick->CTRL |= SysTick_CTRL_TICKINT_Msk;  //Enabale systick interrupt
}

void init_lora()
{
  pinMode(RFM95_RST, OUTPUT);
  digitalWrite(RFM95_RST, HIGH);

  // manual reset
  digitalWrite(RFM95_RST, LOW);
  delay(10);
  digitalWrite(RFM95_RST, HIGH);
  delay(10);

  while (!rf95.init())
  {
    Serial.println("LoRa radio init failed");
    while (1)
      ;
  }
  Serial.println("LoRa radio init OK!");

  // Defaults after init are 434.0MHz, modulation GFSK_Rb250Fd250, +13dbM
  if (!rf95.setFrequency(RF95_FREQ))
  {
    Serial.println("setFrequency failed");
    while (1)
      ;
  }
  Serial.print("Set Freq to: ");
  Serial.println(RF95_FREQ);
  /**
   *  Defaults after init are 434.0MHz, 13dBm, Bw = 125 kHz, Cr = 4/5, Sf = 128chips/symbol, CRC on
   * The default transmitter power is 13dBm, using PA_BOOST.
   * If you are using RFM95/96/97/98 modules which uses the PA_BOOST transmitter pin, then
   * you can set transmitter powers from 5 to 23 dBm:
  */
  rf95.setTxPower(23, false);
}

void send_thru_lora(char *radiopacket)
{
  int length = sizeof(payload);
  int i = 0, j = 0;
  //do not stack
  for (i = 0; i < 200; i++)
  {
    payload[i] = (uint8_t)'0';
  }
  for (i = 0; i < length; i++)
  {
    payload[i] = (uint8_t)radiopacket[i];
  }
  payload[i] = (uint8_t)'\0';
  Serial.print("Sending to LoRa: ");
  Serial.println((char *)payload);
  // Serial.println("sending payload!");
  rf95.send(payload, length); //sending data to LoRa
  delay(100);
}

void receive_lora_data(uint8_t mode)
{
  int count = 0;
  int count2 = 0;
  unsigned long start = millis();
  Serial.println("waiting for LoRa data . . .");
  while (rcv_LoRa_flag == 0)
  {
    if (mode == 4 || mode == 5)
    {
      // timeOut in case walang makuhang data LoRa transmitter ~15 minutes
      if ((millis() - start) > LORATIMEOUTMODE2)
      {
        start = millis();
        // send gateway rssi values if no received from transmitter
        get_rssi(get_logger_version());
        rcv_LoRa_flag = 1;
      }
    }
    else
    {
      // timeOut in case walang makuhang data LoRa transmitter ~4 minutes 260 000
      if ((millis() - start) > LORATIMEOUT)
      {
        Serial.println("Time out reached.");
        start = millis();
        get_rssi(get_logger_version());
        rcv_LoRa_flag = 1;
      }
    }

    if (rf95.available())
    {
      // Should be a message for us now
      if (rf95.recv(buf, &len2))
      {
        int i = 0;
        for (i = 0; i < len2; ++i)
        {
          received[i] = (uint8_t)buf[i];
        }
        received[i] = (uint8_t)'\0';

        if (strstr(received, ">>"))
        { /*NOT LoRa: 0, 2, 6, 7*/
          flashLed(LED_BUILTIN, 3, 60);
          if (mode == 1 || mode == 3 || mode == 4 || mode == 5)
          {
            /*remove 1st & 2nd character*/
            for (byte i = 0; i < strlen(received); i++)
            {
              received[i] = received[i + 2];
            }
            send_thru_gsm(received, get_serverNum_from_flashMem());

            //print RSSI values
            tx_RSSI = (rf95.lastRssi(), DEC);
            Serial.print("RSSI: ");
            Serial.println(tx_RSSI);
          }
          else
          {
            Serial.print("Received Data: ");
            Serial.println(received);
            //print RSSI values
            tx_RSSI = (rf95.lastRssi(), DEC);
            Serial.print("RSSI: ");
            Serial.println(tx_RSSI);
          }
        }

        /*
        else if (received, "STOPLORA")
        {
          // function is working as of 03-12-2020
          count++;
          if( mode == 4)
          {
            Serial.println("Version 4: STOPLORA");
            if (count >= 2)
            {
              Serial.print("count: ");
              Serial.println(count);
              Serial.println("Recieved STOP LoRa.");
              count = 0;
            }
          }
          else
          {
            Serial.print("count: ");
            Serial.println(count);
            Serial.println("Recieved STOP LoRa.");
            count = 0;
            // rcv_LoRa_flag = 1;
          }
        }
        */

        else if (received, "*VOLT:")
        {
          if (mode == 4) // 2 LoRa transmitter
          {
            count2++;
            Serial.print("recieved counter: ");
            Serial.println(count2);

            if (count2 == 1)
            {
              //SENSOR A
              tx_RSSI = (rf95.lastRssi(), DEC);
              Serial.print("RSSI: ");
              Serial.println(tx_RSSI);
              //  parse voltage, MADTB*VOLT:12.33*200214111000
              parse_voltage(received).toCharArray(txVoltage, sizeof(txVoltage));
              Serial.print("TX Voltage A: ");
              Serial.println(txVoltage);
            }
            else if (count2 == 2)
            {
              // SENSOR B
              tx_RSSI_B = (rf95.lastRssi(), DEC);
              Serial.print("RSSI: ");
              Serial.println(tx_RSSI_B);
              parse_voltage(received).toCharArray(txVoltageB, sizeof(txVoltageB));
              Serial.print("TX Voltage B: ");
              Serial.println(txVoltageB);
              delay(500);
              get_rssi(get_logger_version());
              count2 = 0;
              rcv_LoRa_flag = 1;
            }
          }
          else if (mode == 5) // 3 LoRa transmitter
          {
            count2++;
            Serial.print("counter: ");
            Serial.println(count2);

            if (count2 == 1)
            {
              //SENSOR A
              tx_RSSI = (rf95.lastRssi(), DEC);
              Serial.print("RSSI: ");
              Serial.println(tx_RSSI);
              // parse voltage, MADTB*VOLT:12.33*200214111000
              parse_voltage(received).toCharArray(txVoltage, sizeof(txVoltage));
              Serial.print("TX Voltage A: ");
              Serial.println(txVoltage);
            }
            else if (count2 == 2)
            {
              //SENSOR B
              tx_RSSI_B = (rf95.lastRssi(), DEC);
              Serial.print("RSSI: ");
              Serial.println(tx_RSSI);
              //  parse voltage, MADTB*VOLT:12.33*200214111000
              parse_voltage(received).toCharArray(txVoltageB, sizeof(txVoltageB));
              Serial.print("TX Voltage B: ");
              Serial.println(txVoltageB);
            }
            else if (count2 == 3)
            {
              // SENSOR C
              tx_RSSI_C = (rf95.lastRssi(), DEC);
              Serial.print("RSSI: ");
              Serial.println(tx_RSSI_B);
              parse_voltage(received).toCharArray(txVoltageC, sizeof(txVoltageC));
              Serial.print("TX Voltage C: ");
              Serial.println(txVoltageC);
              get_rssi(get_logger_version());
              count2 = 0;
              rcv_LoRa_flag = 1;
            }
          }
          else
          {
            /*only 1 transmitter*/
            tx_RSSI = (rf95.lastRssi(), DEC);
            Serial.print("RSSI: ");
            Serial.println(tx_RSSI);
            //  parse voltage, MADTB*VOLT:12.33*200214111000
            parse_voltage(received).toCharArray(txVoltage, sizeof(txVoltage));
            Serial.print("Received Voltage: ");
            Serial.println(parse_voltage(received));
            get_rssi(get_logger_version());
            rcv_LoRa_flag = 1;
          }
        }
      }
      else
      {
        Serial.println("Recieve failed");
        rcv_LoRa_flag = 1;
      }
    }
  } //while (rcv_LoRa_flag == 0); //if NOT same with condition Loop will exit

  count = 0;
  count2 = 0;
  tx_RSSI = 0;
  tx_RSSI_B = 0;
  rcv_LoRa_flag = 0;
  getSensorDataFlag = false;
  flashLed(LED_BUILTIN, 3, 80);
}

void wake()
{
  OperationFlag = true;
  //detach the interrupt in the ISR so that multiple ISRs are not called
  detachInterrupt(RTCINTPIN);
}

void ringISR()
{
  gsmRingFlag = true;
  detachInterrupt(GSMINT);
}

/**GATEWAY*RSSI,MAD,MADTA,rssi,voltage,MADTB,,,*200212141406 
  *main logger name, MADTA, MADTB, . . .
  *send data to gsm
*/
void get_rssi(uint8_t mode)
{
  char convertRssi[100];
  char convertRssiB[100];
  char convertRssiC[100];
  char logger_name[200];
  String old_rssi = String(tx_RSSI);
  String old_rssi_B = String(tx_RSSI_B);
  String old_rssi_C = String(tx_RSSI_C);
  old_rssi.toCharArray(convertRssi, 100);
  old_rssi_B.toCharArray(convertRssiB, 100);
  old_rssi_C.toCharArray(convertRssiC, 100);
  readTimeStamp();

  String loggerName = String(get_logger_A_from_flashMem());
  loggerName.replace("\r", "");
  loggerName.remove(3);
  loggerName.toCharArray(logger_name, 200);

  for (int i = 0; i < 250; i++)
    rssiString[i] = 0;
  strncpy(rssiString, "GATEWAY*RSSI,", 13);
  strncat(rssiString, logger_name, sizeof(logger_name));
  strncat(rssiString, ",", 1);
  strncat(rssiString, get_logger_B_from_flashMem(), 20);
  strncat(rssiString, ",", 1);
  strncat(rssiString, convertRssi, 100);
  strncat(rssiString, ",", 1);
  strncat(rssiString, txVoltage, sizeof(txVoltage)); //voltage working 02-17-2020
  // strncat(dataToSend, parse_voltage(received), sizeof(parse_voltage(received)));
  if (mode == 4)
  {
    strncat(rssiString, ",", 1);
    strncat(rssiString, get_logger_C_from_flashMem(), 20);
    strncat(rssiString, ",", 1);
    strncat(rssiString, convertRssiB, 100);
    strncat(rssiString, ",", 1);
    strncat(rssiString, txVoltageB, sizeof(txVoltageB)); //voltage working 02-17-2020
    // strncat(dataToSend, parse_voltage_B(received), sizeof(parse_voltage_B(received)));
  }
  else if (mode == 5)
  {
    strncat(rssiString, ",", 1);
    strncat(rssiString, get_logger_C_from_flashMem(), 20);
    strncat(rssiString, ",", 1);
    strncat(rssiString, convertRssiB, 100);
    strncat(rssiString, ",", 1);
    strncat(rssiString, txVoltageB, sizeof(txVoltageB)); //voltage working 02-17-2020
    strncat(rssiString, ",", 1);
    strncat(rssiString, get_logger_D_from_flashMem(), 20); //sensorD
    strncat(rssiString, ",", 1);
    strncat(rssiString, convertRssiC, 100);
    strncat(rssiString, ",", 1);
    strncat(rssiString, txVoltageC, sizeof(txVoltageC));
  }
  else
  {
    strncat(rssiString, ",*", 2);
    strncat(rssiString, Ctimestamp, sizeof(Ctimestamp));
    // Serial.println(rssiString);
  }
  delay(500);
  send_thru_gsm(rssiString, get_serverNum_from_flashMem());
  delay(1000);
}

/**
 * Get data allocated from flash memory
*/
char *stationName_from_flashMem()
{
  String get_cmd;
  char new_cmd[10];
  sensCommand = passCommand.read();
  get_cmd = sensCommand.stationName;
  get_cmd.replace("\r", "");
  get_cmd.toCharArray(new_cmd, 10);
  return new_cmd;
}

char *get_logger_A_from_flashMem()
{
  String getLoggerA;
  char new_loggerA[10];
  loggerName = flashLoggerName.read();
  getLoggerA = loggerName.sensorA;
  getLoggerA.replace("\r", "");
  getLoggerA.toCharArray(new_loggerA, 10);
  return new_loggerA;
}

char *get_logger_B_from_flashMem()
{
  String getLoggerB;
  char new_loggerB[10];
  loggerName = flashLoggerName.read();
  getLoggerB = loggerName.sensorB;
  getLoggerB.replace("\r", "");
  getLoggerB.toCharArray(new_loggerB, 10);
  return new_loggerB;
}

char *get_logger_C_from_flashMem()
{
  String getLoggerC;
  char new_loggerC[10];
  loggerName = flashLoggerName.read();
  getLoggerC = loggerName.sensorC;
  getLoggerC.replace("\r", "");
  getLoggerC.toCharArray(new_loggerC, 10);
  return new_loggerC;
}

char *get_logger_D_from_flashMem()
{
  String getLoggerD;
  char new_loggerD[10];
  loggerName = flashLoggerName.read();
  getLoggerD = loggerName.sensorD;
  getLoggerD.replace("\r", "");
  getLoggerD.toCharArray(new_loggerD, 10);
  return new_loggerD;
}

String get_serverNum_from_flashMem()
{
  String flashNum;
  flashServerNumber = newServerNum.read();
  flashNum = flashServerNumber.inputNumber;
  flashNum.replace("\r", "");
  return flashNum;
}

char *get_password_from_flashMem()
{
  char charPass[50];
  String flashPass;
  flashPassword = flashPasswordIn.read();
  flashPass = flashPassword.keyword;
  flashPass.replace("\r", "");
  flashPass.toCharArray(charPass, sizeof(charPass));
  return charPass;
}

/**
 * 0 - default for GSM sending
 * 1 - send to LoRa with >> and << added to data
*/
void send_rain_data(uint8_t sendTo)
{
  char csq[5];
  char temp[6];
  char volt[6];
  getCSQ().toCharArray(csq, 5);
  dtostrf((readTemp()), 5, 2, temp);
  dtostrf(rainTips, 3, 2, sendRainTip); //convert rainTip to char
  dtostrf((BatteryVoltage(get_logger_version())), 4, 2, volt);
  getPwrdFromMemory();
  readTimeStamp();

  for (int i = 0; i < DATALEN; i++)
    dataToSend[i] = 0;
  /* MADTAW,32.00,0.00,0.82,99,200415171303 
      station name, temperature, raintips, input voltage, gsm csq */
  if (sendTo == 1)
  {
    strncpy(dataToSend, ">>", 2);
    strncat((dataToSend), (get_logger_A_from_flashMem()), (20));
  }
  else
  {
    strncpy((dataToSend), (get_logger_A_from_flashMem()), (20));
  }
  // strncpy((dataToSend), (get_logger_A_from_flashMem()), (20));
  strncat(dataToSend, "W", 1);
  strncat(dataToSend, ",", 1);
  strncat(dataToSend, temp, sizeof(temp));
  strncat(dataToSend, ",", 1);
  strncat(dataToSend, sendRainTip, sizeof(sendRainTip));
  strncat(dataToSend, ",", 1);
  strncat(dataToSend, volt, sizeof(volt));
  strncat(dataToSend, ",", 1);
  strncat(dataToSend, csq, sizeof(csq));
  strncat(dataToSend, ",", 1);
  strncat(dataToSend, Ctimestamp, sizeof(Ctimestamp));
  if (sendTo == 1)
  {
    strncat(dataToSend, "<<", 2);
  }
  delay(500);
  if (sendTo == 1)
  {
    send_thru_lora(dataToSend);
  }
  else
  {
    send_thru_gsm(dataToSend, get_serverNum_from_flashMem());
    delay(500);
    resetRainTips();
  }
}

void flashLed(int pin, int times, int wait)
{
  for (int i = 0; i < times; i++)
  {
    digitalWrite(pin, HIGH);
    delay(wait);
    digitalWrite(pin, LOW);
    if (i + 1 < times)
    {
      delay(wait);
    }
  }
}

char *read_batt_vol(uint8_t ver)
{
  char volt[6];
  char voltMessage[200];
  dtostrf((BatteryVoltage(ver)), 4, 2, volt);
  readTimeStamp();

  if (ver == 6)
  {
    strncpy(voltMessage, ">>", 2);
  }
  else
  {
    strncpy(voltMessage, get_logger_A_from_flashMem(), 20);
  }
  // strncpy(voltMessage, ">>", 2);
  // strncat(voltMessage, stationName_from_flashMem(), 10);
  strncat(voltMessage, "*VOLT:", 7);
  strncat(voltMessage, volt, sizeof(volt));
  strncat(voltMessage, "*", 1);
  if (ver == 6)
  {
    strncat(voltMessage, Ctimestamp, sizeof(Ctimestamp));
    strncat(voltMessage, "<<", 2);
  }
  else
  {
    strncat(voltMessage, Ctimestamp, sizeof(Ctimestamp));
  }
  return voltMessage;
}

// Measure battery voltage using divider on Feather M0
float BatteryVoltage(uint8_t ver)
{
  float measuredvbat;
  /*
  int vbatpin;
  if (ver == 1)
  {
    measuredvbat = analogRead(VBATPIN); //Measure the battery voltage at pin A7
    measuredvbat *= 2;                  // we divided by 2, so multiply back
    measuredvbat *= 3.3;                // Multiply by 3.3V, our reference voltage
    measuredvbat /= 1024;               // convert to voltage
  }
  else
  {
    */
  //Voltage Divider 1M ; 100k ;
  measuredvbat = analogRead(VBATEXT);
  measuredvbat *= 3.3;    // reference voltage
  measuredvbat /= 1024.0; // adc max count
  measuredvbat *= 11.0;   // (100k+1M)/100k
  // }
  return measuredvbat;
}

/*
  ** interrupts EIC
  EXTERNAL_INT_2: A0, A5, 10
  EXTERNAL_INT_4: A3, 6
  EXTERNAL_INT_5: A4, 7
  EXTERNAL_INT_6: 8, SDA
  EXTERNAL_INT_7: 9, SCL
  EXTERNAL_INT_9: A2, 3
  EXTERNAL_INT_10: TX, MOSI
  EXTERNAL_INT_11: RX, SCK
*/
void init_Sleep()
{
  //working to as of 05-17-2019
  SYSCTRL->XOSC32K.reg |= (SYSCTRL_XOSC32K_RUNSTDBY | SYSCTRL_XOSC32K_ONDEMAND); // set external 32k oscillator to run when idle or sleep mode is chosen
  REG_GCLK_CLKCTRL |= GCLK_CLKCTRL_ID(GCM_EIC) |                                 // generic clock multiplexer id for the external interrupt controller
                      GCLK_CLKCTRL_GEN_GCLK1 |                                   // generic clock 1 which is xosc32k
                      GCLK_CLKCTRL_CLKEN;                                        // enable it
  while (GCLK->STATUS.bit.SYNCBUSY)
    ; // write protected, wait for sync

  EIC->WAKEUP.reg |= EIC_WAKEUP_WAKEUPEN4; // Set External Interrupt Controller to use channel 4 (pin 6)
  EIC->WAKEUP.reg |= EIC_WAKEUP_WAKEUPEN5; // Set External Interrupt Controller to use channel 2 (pin A4)
  // EIC->WAKEUP.reg |= EIC_WAKEUP_WAKEUPEN2; // channel 2 (pin A0)

  PM->SLEEP.reg |= PM_SLEEP_IDLE_CPU; // Enable Idle0 mode - sleep CPU clock only
  //PM->SLEEP.reg |= PM_SLEEP_IDLE_AHB; // Idle1 - sleep CPU and AHB clocks
  //PM->SLEEP.reg |= PM_SLEEP_IDLE_APB; // Idle2 - sleep CPU, AHB, and APB clocks

  // It is either Idle mode or Standby mode, not both.
  SCB->SCR |= SCB_SCR_SLEEPDEEP_Msk; // Enable Standby or "deep sleep" mode
}

void getPwrdFromMemory()
{
  sensCommand = passCommand.read();
}

/**
 * Get custom due sensor data.
 * ~5 minutes timeout if no data read.  
 * mode in sending data: 1-gsm ; 0 - LoRa(defualt) ; 2 - V5 logger
*/
void get_Due_Data(uint8_t mode, String serverNum)
{
  unsigned long start = millis();

  /*Serial.println("starting delay please wait . . .");
  // delay 1 minute before getting due data
  delay(DUEDELAY);
  Serial.println("DUE delay reached!");*/

  readTimeStamp();
  turn_ON_due(get_logger_version());
  delay(500);

  sensCommand = passCommand.read();
  command[0] = '\0';
  strncpy((command), (sensCommand.senslopeCommand), (10));
  strncat(command, "/", 1);
  strncat(command, Ctimestamp, sizeof(Ctimestamp));
  Serial.println(command);
  DUESerial.write(command);

  while (customDueFlag == 0)
  {
    // timeOut in case walang makuhang data sa due
    if ((millis() - start) > DUETIMEOUT)
    {
      start = millis();
      no_data_from_senslope(mode);
      customDueFlag = 1;
    }

    for (int i = 0; i < 250; ++i)
      streamBuffer[i] = 0x00;
    DUESerial.readBytesUntil('\n', streamBuffer, 250);
    delay(500);

    if (strstr(streamBuffer, ">>"))
    {
      if (strstr(streamBuffer, "*"))
      {
        Serial.println("Getting sensor data. . .");
        if (mode == 0 || mode == 1)
        {
          /**
            * Remove 1st and 2nd character data in string
            * Not needed in GSM mode 
          */
          for (byte i = 0; i < strlen(streamBuffer); i++)
          {
            streamBuffer[i] = streamBuffer[i + 2];
          }
          // send_thru_gsm(streamBuffer, get_serverNum_from_flashMem());
          send_thru_gsm(streamBuffer, serverNum);
          flashLed(LED_BUILTIN, 2, 100);
          DUESerial.write("OK");
        }
        else if (mode == 6 || mode == 7)
        {
          strncat(streamBuffer, "<<", 2);
          delay(10);
          send_thru_lora(streamBuffer);
          flashLed(LED_BUILTIN, 2, 100);
          DUESerial.write("OK");
          // send_thru_lora(streamBuffer);
          // flashLed(LED_BUILTIN, 2, 100);
          // DUESerial.write("OK");
        }
        else
        {
          send_thru_lora(streamBuffer);
          flashLed(LED_BUILTIN, 2, 100);
          DUESerial.write("OK");
        }
      }
      else
      {
        //maglagay ng counter max 5 then exit
        Serial.println("Message incomplete");
        DUESerial.write("NO");
      }
    }
    else if (strstr(streamBuffer, "STOPLORA"))
    {
      /*if (mode == 0 || mode == 2)
      {
        delay(1000);
        send_thru_lora(read_batt_vol(mode));
        delay(1500); //needed for the gsm to wait until sending
        send_thru_lora("STOPLORA");
      }*/
      Serial.println("Done getting DUE data!");
      streamBuffer[0] = '\0';
      customDueFlag = 1;
    }
  }
  if (mode == 2 || mode == 6 || mode == 7 || mode == 8)
  {
    send_thru_lora(read_batt_vol(mode));
  }
  turn_OFF_due(get_logger_version());
  flashLed(LED_BUILTIN, 4, 90);
  customDueFlag = 0;
  getSensorDataFlag = true;
}

/**
 * Sends no data from senslope if no data available
 * mode :     1 - gsm
 * default:   0 - LoRa
 *Serial.println("[0] Sendng data using GSM only");
  Serial.println("[1] Version 5 datalogger LoRa with GSM");
  Serial.println("[2] LoRa transmitter for version 5 datalogger");
  Serial.println("[3] Gateway Mode with only ONE LoRa transmitter");
  Serial.println("[4] Gateway Mode with TWO LoRa transmitter");
  Serial.println("[5] Gateway Mode with THREE LoRa transmitter");
  Serial.println("[6] LoRa transmitter for Raspberry Pi");
  Serial.println("[7] Sends rain gauge data via LoRa");
*/
void no_data_from_senslope(uint8_t mode)
{
  readTimeStamp();
  sensCommand = passCommand.read(); //read from flash memory
  Serial.println("No data from senslope");
  streamBuffer[0] = '\0';

  if (mode == 1 || mode == 0)
  {
    strncpy((streamBuffer), (get_logger_A_from_flashMem()), (20));
  }
  else
  {
    strncpy(streamBuffer, ">>", 2);
    strncat((streamBuffer), (get_logger_A_from_flashMem()), (20));
  }

  strncat(streamBuffer, "*NODATAFROMSENSLOPE*", 22);
  strncat(streamBuffer, Ctimestamp, sizeof(Ctimestamp));

  if (mode == 1 || mode == 0)
  {
    send_thru_gsm(streamBuffer, get_serverNum_from_flashMem());
  }
  else if (mode == 2)
  {
    send_thru_lora(streamBuffer);
  }
  else
  {
    strncat(streamBuffer, "<<", 2);
    send_thru_lora(streamBuffer);
  }
  // Serial.println(streamBuffer);
  customDueFlag = 1;
}

void turn_ON_due(uint8_t mode)
{
  Serial.println("Turning ON Custom Due. . .");
  digitalWrite(DUETRIG, HIGH);
  delay(100);
}

void turn_OFF_due(uint8_t mode)
{
  Serial.println("Turning OFF Custom Due. . .");
  digitalWrite(DUETRIG, LOW);
  delay(100);
}

void rainISR()
{
  detachInterrupt(digitalPinToInterrupt(RAININT));
  unsigned long interrupt_time = millis();
  if (interrupt_time - last_interrupt_time > DEBOUNCE_TIME)
  {
    rainTips += 0.5;
  }
  last_interrupt_time = interrupt_time;
  if (OperationFlag == true || debug_flag == 1)
  {
    attachInterrupt(RAININT, rainISR, FALLING);
  }
  else
  {
    rainFallFlag = true;
  }
}

void resetRainTips()
{
  rainTips = 0.00;
  delay(75);
  dtostrf(rainTips, 3, 2, sendRainTip); //convert rainTip to char
  Serial.print("Rain tips: ");
  Serial.println(rainTips);
}

void send_rain_tips()
{
  // delay(500);
  send_rain_data(0);
  // delay(500);
  // send_thru_gsm(dataToSend, get_serverNum_from_flashMem());
  // delay(500);
  // resetRainTips();
  // delay(1500);
}

String parse_voltage(char *toParse)
{
  int i = 0;
  String parse_volt;

  //MADTB*VOLT:12.33*200214111000
  char *buff = strtok(toParse, ":");
  while (buff != 0)
  {
    char *separator = strchr(buff, '*');
    if (separator != 0)
    {
      *separator = 0;
      if (i == 1) //2nd appearance
      {
        parse_volt = buff;
      }
      i++;
    }
    buff = strtok(0, ":");
  }
  return parse_volt;
}

/*
char *parse_voltage(char *toParse)
{
  int i = 0;
  char final_volt[200];
  String parse_volt;

  //MADTB*VOLT:12.33*200214111000
  char *buff = strtok(toParse, ":");
  while (buff != 0)
  {
    char *separator = strchr(buff, '*');
    if (separator != 0)
    {
      *separator = 0;
      if (i == 1)
      {
        parse_volt = buff;
        // Serial.println(parse_volt);
      }
      i++;
    }
    buff = strtok(0, ":");
  }
  parse_volt.toCharArray(final_volt, 200);
  parse_volt.toCharArray(txVoltage, sizeof(txVoltage));
  Serial.println(final_volt);
  return buff;
}

char *parse_voltage_B(char *toParse)
{
  int i = 0;
  char final_volt[200];
  String parse_volt;

  //MADTB*VOLT:12.33*200214111000
  char *buff = strtok(toParse, ":");
  while (buff != 0)
  {
    char *separator = strchr(buff, '*');
    if (separator != 0)
    {
      *separator = 0;
      if (i == 1)
      {
        parse_volt = buff;
        // Serial.println(parse_volt);
      }
      i++;
    }
    buff = strtok(0, ":");
  }
  parse_volt.toCharArray(final_volt, 200);
  parse_volt.toCharArray(txVoltageB, sizeof(txVoltageB));
  Serial.println(final_volt);
  return buff;
}

char *parse_voltage(char *toParse)
{
  int i = 0;
  char final_volt[200];
  String parse_volt;

  //MADTB*VOLT:12.33*200214111000
  char *buff = strtok(toParse, ":");
  while (buff != 0)
  {
    char *separator = strchr(buff, '*');
    if (separator != 0)
    {
      *separator = 0;
      if (i == 1)
      {
        parse_volt = buff;
      }
      i++;
    }
    buff = strtok(0, ":");
  }
  parse_volt.toCharArray(final_volt, 200);
  return final_volt;
}
*/
