madmarkarnel/lora-transmission/(commit log)

2019-05-28 working low power ~100uA sleep current working due to m0 serial
2019-05-31 added no data from sensors added alarm every 0,5,10,15 ; 30,35,40,45 ;ABCD added Debug Mode before startUp
2019-07-22 working rtc hard setting interval in interrupt wakeUp
2019-07-25 -added sensor name in flash memory -access sensor name in no data from senslope
2019-08-23 -updated print functions
2019-09-19 - IndexError: list index out of range - print("RTC", ts[2].decode('ascii').strip())
2019-10-01 Arabica Datalogger - working all functions - RTC alarm interrupt - low power LoRa, ~1uA sleep mode
2019-10-04 arabica.ino - fixed bug: sampling data after exiting debug mode and once turned ON without debug mode
    [arabica.ino]
2019-11-18 - added battery voltage monitor sending
2019-11-25 working serial2 from pin 10 and 11 sim800 working
2020-01-14 - working 2 interrupt (rtc and rain gauge) - sleep mode when no rain detected - resets rain after sending sensor data
    [m0_sleep.ino, rtc.ino]
2020-01-17 - working gsm sleep mode ~1mA - gsm funtions in different folder - working rain gauge interrupt
2020-01-23 - working rain and sensor interrupt
2020-01-29 detect "OK" and "ERROR" using regexp
    [gsm.ino]
2020-02-03 - not working reciv LoRa
    [gsm.ino, m0_sleep.ino, rtc.ino]
2020-02-07 Working all features 1. Send rain tips interrupt 2. Get due data 3. Receive LoRa data from remote
2020-02-07 - fixed white space "\r" after site name
    [m0_sleep.ino, rtc.ino]
2020-02-14 measure battery voltage update
2020-02-14 Added voltage parsing
2020-02-21 combine print and change
2020-02-27 pcb boards
    [gsm_LoRa_due.brd, gsm_LoRa_due.sch]
2020-02-28 added SPI connector
    [gsm_LoRa_due.brd, gsm_LoRa_due.sch]
2020-02-28 barebones atsamd21
    [atsamdg21_rtc.brd, atsamdg21_rtc.sch]
2020-03-02 Updated names on traces
    [gsm_LoRa_due.brd, gsm_LoRa_due.sch]
2020-03-03 Added power IC switch for GSM Updated names of components
    [gsm_LoRa_due.brd, gsm_LoRa_due.sch]
2020-03-05 Edited via size
    [gsm_LoRa_due.brd]
2020-03-06 added gsm reset, power ON and power OFF
    [m0_sleep.ino, rtc.ino]
2020-03-06 updated traces and polygon
    [gsm_LoRa_due.brd]
2020-04-15 *Updated sending_thru_gsm - sending failed availble when gsm not connected *getCSQ - faster getting csq - 99 no csq available
    [gsm.ino, m0_sleep.ino, rtc.ino]
2020-04-17 *Updated parsing voltage *Added 3 receiver and sensor name *Added special case for MAR (send sensor and rain data via LoRa)
2020-05-04 - sample embedded board
    [atsamdg21_v1.20.brd, atsamdg21_v1.20.sch]
2020-05-05 working sms receive command interrupt when ring
2020-05-05 addded ring pin to A0
    [gsm_LoRa_due.brd, gsm_LoRa_due.sch]
2020-05-15 update 05/15
    [atsamdg21_v1.20.brd]
2020-05-22 05/22 update
    [atsamdg21_v1.20.brd, atsamdg21_v1.20.sch]
2020-05-22 -updated usb pin connections, overlap, ground plane bottom
    [atsamdg21_v1.20.brd, atsamdg21_v1.20.sch]
2020-05-29 - fixed bug in sending sms - auto connect sim network depending on stored number - faster csq reading
    [gsm.ino, m0_sleep.ino, rtc.ino]
2020-05-29 update 05/29
    [atsamdg21_v1.20.brd, atsamdg21_v1.20.sch]
2020-06-09 - updated traces - added ring gsm connection
    [atsamdg21_v1.20.sch]
2020-06-09 v5autoconfig; create new folder for script v5autoconfig/v5autoconfig.zip = complete copy v5autoconfig.py = main script datav5config.csv = config settings docuv5autoconfig.txt = documentation
    [datav5config.csv, docuv5autoconfig.txt]
2020-06-10 -added gsm ring functions -updated routing
    [atsamdg21_v1.20.brd, atsamdg21_v1.20.sch]
2020-06-11 v5autoconfig/ add new functions: loggername, mcupassword, sensorcommand
    [datav5config.csv, docuv5autoconfig.txt]
2020-06-18 update 06192020
    Major changes:
    Added timeout for non-responding serial write commands.
    Implemented csv checking before mcu programming.
    Included error raising for csv input errors.
    Extended set datetime functionality to set timestamp in the format YYYY-MM-DD HH:MM:SS.
    Minor:
    On screen instruction translated to English.
    Use upper case for text comparison.
    Ignore blank rows in csv file.
    [docuv5autoconfig.txt]
2020-06-26 update 06262020
    1. added datetime and battery voltage readout
    2. validation of received csq, voltage, and timestamp data
    3. draft function for sensor trigger.
    Minor changes:
    1. added print parameter for text finding function
    2. acquire device 3sec after startup
    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
2020-06-30 Gerber files, assembly
    [copper_bottom.gbr, copper_top.gbr, drill_1_16.xln, gerber_job.gbrjob, profile.gbr, silkscreen_bottom.gbr, silkscreen_top.gbr, soldermask_bottom.gbr]
2020-07-04 update 070420
    Use json file to store config settings and data logs, filename will contain site name, personnel name, and timestamp
    Retrieve config settings before running test processes: servernum, loggerversion, sendingtime, mcupassword, loggernames, sensorcommand
    Replace undecodeable serial characters with '?'
    Add additional CSQ sampling to obtain odd number of samples for median computation
    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
    [v5troubleshooter.py]
2020-07-10 update 071020
    Integrated supply of solutions for known v5 problems
    Simplified all getters to general get_config function
    Included 'about' parameter to hold datalogger name, personnel, and timestamp
    Included 'result' and 'solution' parameter in log file
    Categorized result as "PASS" or "FAIL"
    Integrated pass/fail criteria:
    csq: pass if greater than 9 but less than 99
    sms: fail if it did not receive "sms sent" output
    time: pass if timedelta < 15 seconds
    batt: pass if greater than 10.5 but less than 14
    trig: fail if it received "nodatafromsenslope" output
    Parsed logger version output
    Decreased delay after each serial write to 2s
    Removed dump_config function to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
    [v5troubleshooter.py]
2020-07-18 update 071520
    Implement averaging for voltage sampling
    Update csq solution message
    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
2020-08-18 Added IMU sensors in V5 dataloggers
2020-09-14 Updated IMU code - data string - added to menu (LoRa or GSM)
2020-09-15 IMU functions - added flash memory parameters - get raw data function using memory allocation - calibrated data function
2020-09-21 -added power pin for IMU (power ON on wakeUp and power OFF on sleep) -added temp on IMU string
2020-09-28 Updated IMU get data functions
2020-10-08 -added temperature in IMU data -add flash memory storage for IMU calib or raw data parameters -fixed voltage reading error in surficial tilt mode(PIN 9 is not usable if used as VBAT reading) -updated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
    [gsm.ino, rtc.ino, surficialTilt.ino]
2020-10-19 -updated turning on GSM and manual GSM connect -interchanged sending of IMU data and rain data
2020-10-23 -updated power pin of IMU -delay_millis function added (using millis() not delay) -updated GSM wakeup timeout
2020-11-15 -common sensor sampling commands -added rain gauge only datalogger version(11)
2021-02-03 -added GSM power selector (sleep, always ON, OFF/ON) -change GSM baud rate to 115200 -updated GSM reset function -updated menu selection
    [gsm.ino, rtc.ino, surficialTilt.ino]
2021-02-04 -updated UI of debug menu for readability -fixed storing of data in flash memory (names, password etc.) -fixed manual GSM commands -fixed error in parsing GSM reply buffer
    [gsm.ino, rtc.ino, surficialTilt.ino]
2021-02-19 Added new parameter: gsmpowmode Added new exception to be raised for unresponsive device. Added error message for mcu timestamp readout that begins with '65' Updated message display. Added gsmpowmode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
    [datav5config.csv]
2021-02-22 - added 5 minutes timeout to exit debug menu - added reset at the start of the program - added current firmware version in menu - updated menu UI
    [gsm.ino, rtc.ino, surficialTilt.ino]
2021-03-10 - updated initialization setting of gsm - added: reset gsm when sending failed - added OTA functions - add watchdog timer
    [gsm.ino]
2021-03-10 - added watchdog timers= in each logger functions - added print config parameters in debug menu - refactored getting logger voltage - refactored parsing function in receiving LoRa
2021-03-10 - added disable watchdog timers in debug mode - updated functions
